s-bhatia1216/mt-rainier-railroad/physical_design/power_distribution_center.JPG

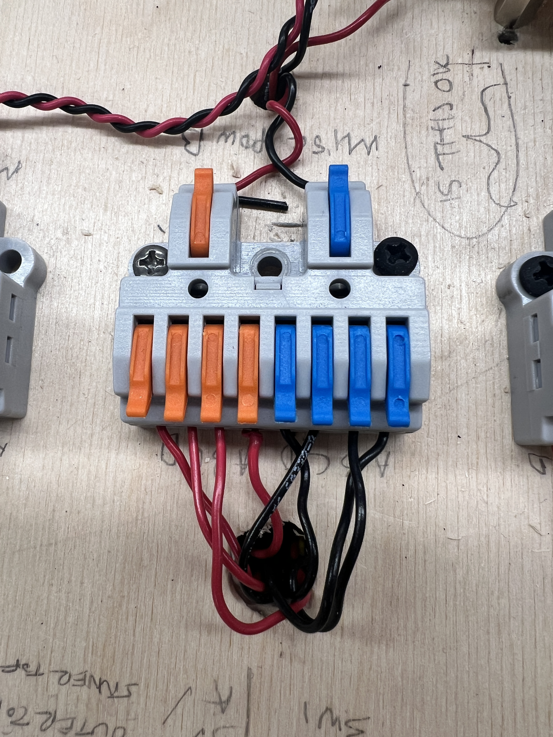
physical_design/power_distribution_center.JPG
