s-bhatia1216/mt-rainier-railroad/physical_design/tof_sensor.JPG

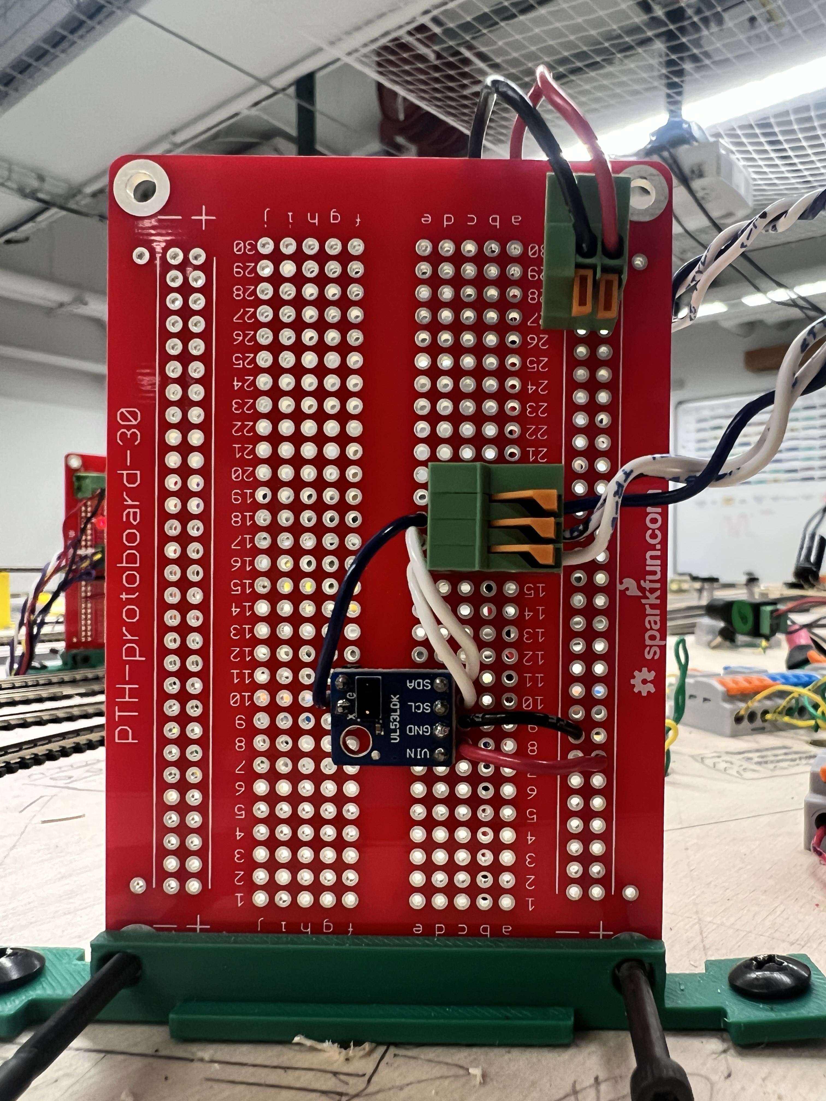
physical_design/tof_sensor.JPG
