s-bhatia1216/mt-rainier-railroad/Todos.docx

- Test super pro ram test
- Wiring
  - Wire power lines and ground lines from sensors into power centers
  - Wire power lines and ground lines from trees into power centers
  - Wire the voltage regulator power center (orange board)
  - Rewire trickle charge circuit – hriday is doing this
  - Add buffer onto the vector board
  - Wire the blue relay lines from the two relay plates, wire trickle charge white and blue lines from the 4 trickle charge centers
  - Install trickle charge 2’s screw properly
