s-bhatia1216/mt-rainier-railroad/DCC/Arduino/Todos_withtestdayplan.docx

Todos

- Mount vector board into wood
- URGENT
  - Wiring
    - Add wiring to the middle track and the right most track that’s connected to the 12V power of the rails (parallelize) using the power distribution block
    - Check all the kinks as underlined
- asf
  - Staple things underneath
  - Check all loose wires with pull tests
  - Sign names into the wood
  - fs
  - Do eraser thing on tracks
  - Make a document that indicates what to connect and start for testing

Test Day

- Power
  - Plug in 9V into VB
  - Plug in 9V into the MISC power distribution center
  - Plug in 24V into the rail power distribution center
  - Plug in Blue USB into the rail power Arduino
  - Plug in the 12V into the rail power Arduino
- Commands
  - Plug in the FTDI cable into the VB
  - Plug in the umblical cord

CONOPS

1. Starts at the rightmost point
2. FIRST OUTER LOOP (1x)
  a. SW1 is low to go straight into the SW2
  b. SW2 is low to go straight into the trk X
  c. SW4 is high to enter the trk5 outer loop
  d. SW3 is low to go straight into default loop
3. SECOND OUTER LOOP TO GO INTO INNER LOOP
  a. SW1 is low to go straight into the SW2
  b. SW2 is low to go straight into the trk X
  c. SW4 is high to enter the trk5 outer loop
  d. SW3 is low to go straight into default loop
4. THIRD INNER LOOP – assumes we just completed an outer loop at SW3
  a. SW1 is high to exit the default loop into the SW2
  b. SW2 is low to enter the trk4 inner loop
  c. SW3 is high to exit the trk4 inner loop
5. FOUTH INNER LOOP– assumes we just completed an outer loop at SW3
  a. SW1 is high to exit the default loop into the SW2
  b. SW2 is low to enter the trk4 inner loop
  c. SW3 is high to exit the trk4 inner loop
6. EXIT THE TRACK
  a. SW1 is high to exit the default loop into the SW2
  b. SW2 is low to go straight into the trk X
  c. SW4 is low to exit the track!
