s-bhatia1216/mt-rainier-railroad/electrical_schematics/relay_schematic.png

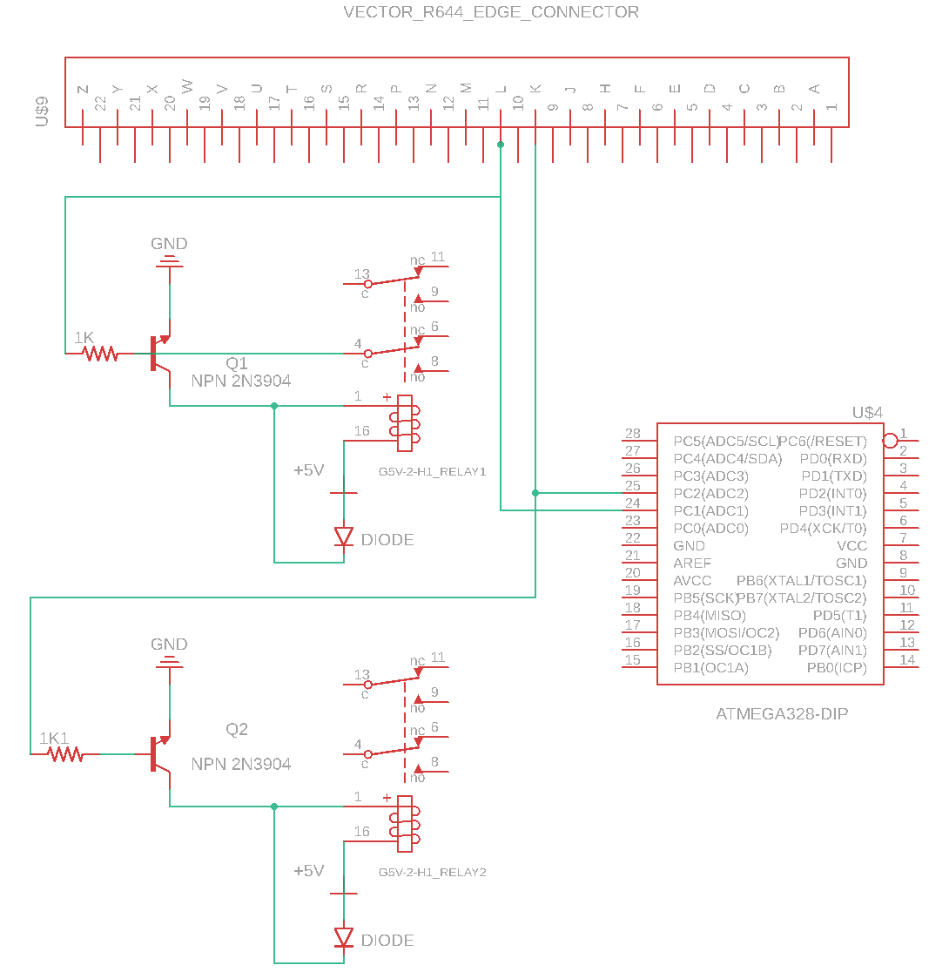
electrical_schematics/relay_schematic.png
