s-bhatia1216/mt-rainier-railroad/electrical_schematics/servo_schematic.png

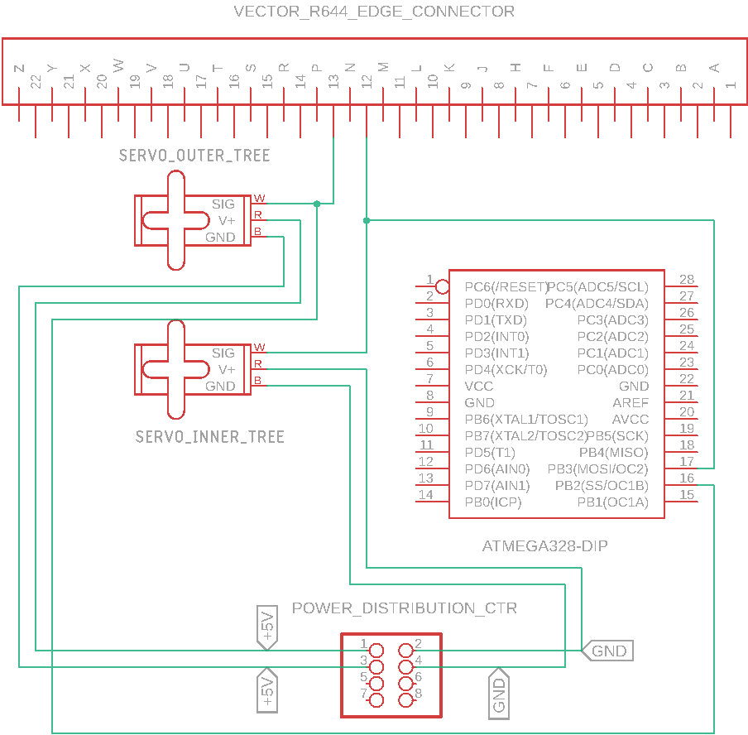
electrical_schematics/servo_schematic.png
