s-bhatia1216/mt-rainier-railroad/electrical_schematics/tof_schematic.png

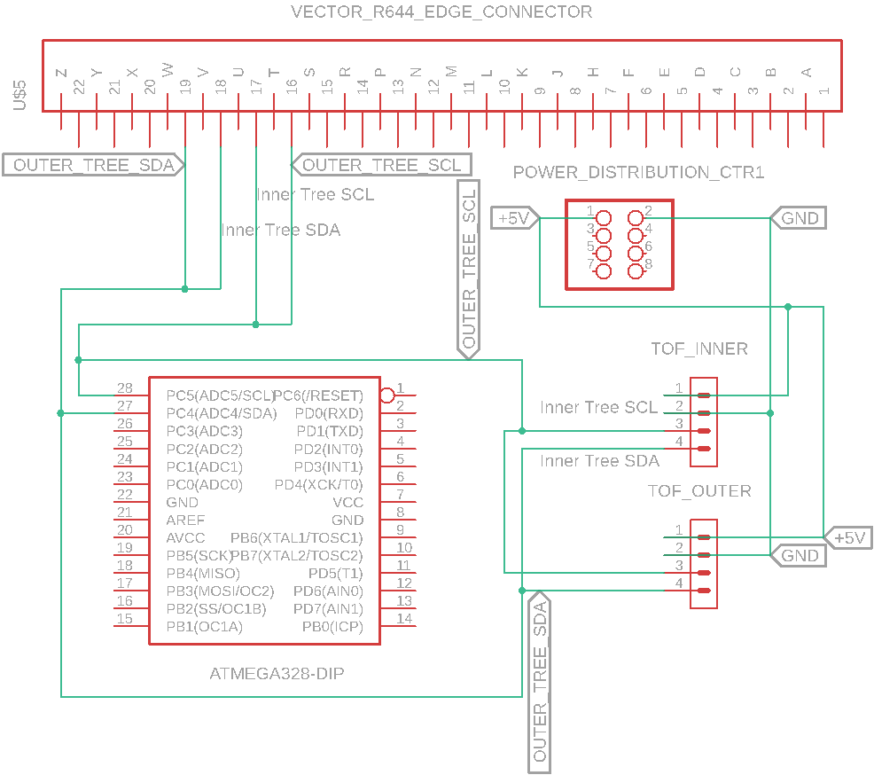
electrical_schematics/tof_schematic.png
