s-bhatia1216/mt-rainier-railroad/physical_design/power_relay.JPG

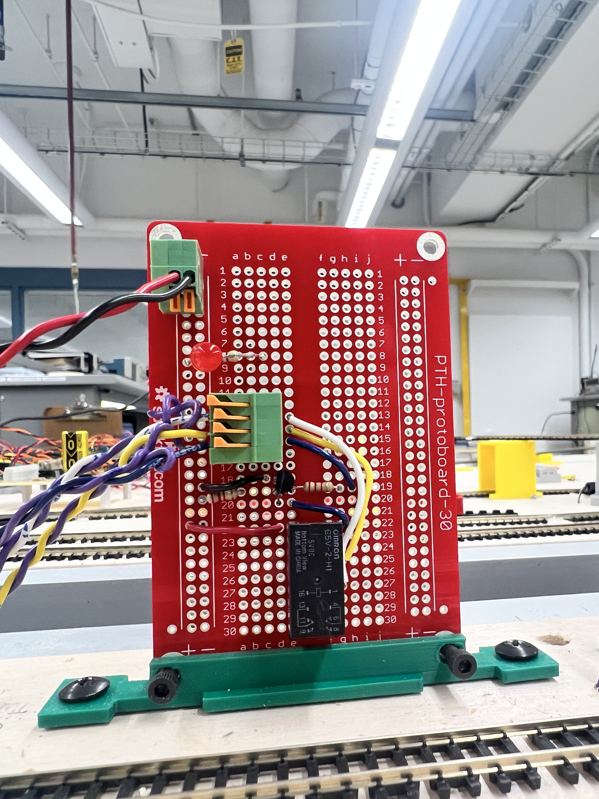
physical_design/power_relay.JPG
