s-bhatia1216/mt-rainier-railroad/physical_design/vector_board.JPG

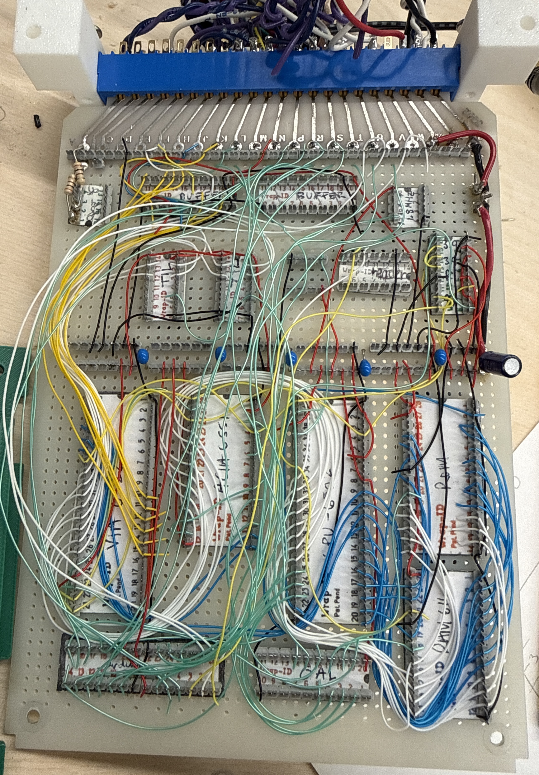
physical_design/vector_board.JPG
