s-bhatia1216/mt-rainier-railroad/electrical_schematics/General_Schematic_Files/Relay_Charge_Circuit.sch

## EAGLE design electrical_schematics/General_Schematic_Files/Relay_Charge_Circuit.sch (2026-05-09)

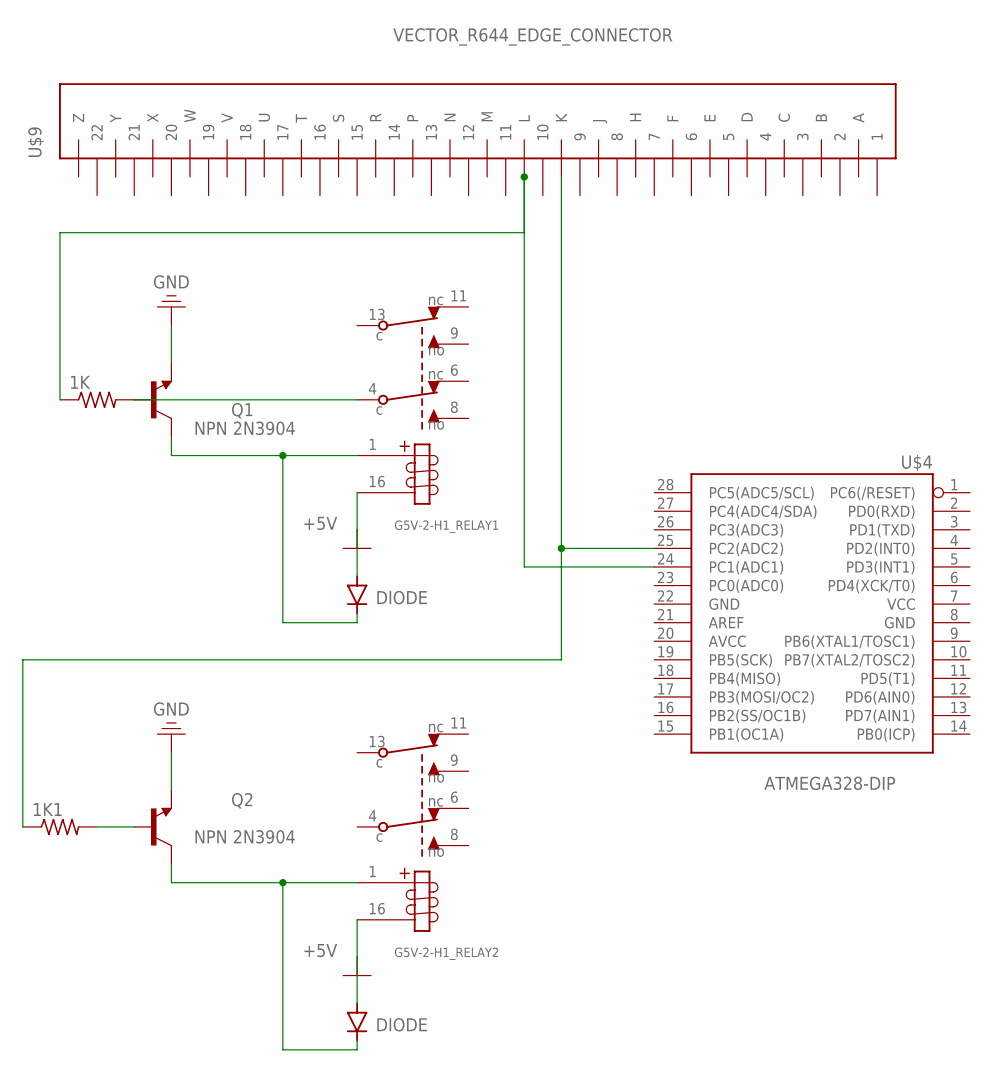
[picture p10: schematic Relay_Charge_Circuit.sch]

Parts:
1K, 1K1: R-US_0414/5V; 0414V
G5V-2-H1_RELAY1, G5V-2-H1_RELAY2: RELAY_DPDT; DIP16_RELAY
Q1, Q2: NPN 2N3904; TO92
U$3, U$6: DIODE; DIODE-DO-220AA(SMP)
U$4: ATMEGA328-DIP; DIP28
U$9: VECTOR_R644_EDGE_CONNECTOR; VECTOR44

Connections:
+5V: G5V-2-H1_RELAY1.16, G5V-2-H1_RELAY2.16, U$3.ANODE, U$6.ANODE
GND: Q1.3 (E), Q2.3 (E)
unnamed: G5V-2-H1_RELAY1.1, Q1.1 (C), U$3.CATHODE
unnamed: 1K.2, G5V-2-H1_RELAY1.P1, Q1.2 (B)
unnamed: 1K.1, U$4.24 (PC1(ADC1)), U$9.P$L (L)
unnamed: 1K1.2, Q2.2 (B)
unnamed: 1K1.1, U$4.25 (PC2(ADC2)), U$9.P$K (K)
unnamed: G5V-2-H1_RELAY2.1, Q2.1 (C), U$6.CATHODE
