s-bhatia1216/mt-rainier-railroad/electrical_schematics/General_Schematic_Files/Servo_Schematic.sch

## EAGLE design electrical_schematics/General_Schematic_Files/Servo_Schematic.sch (2026-05-09)

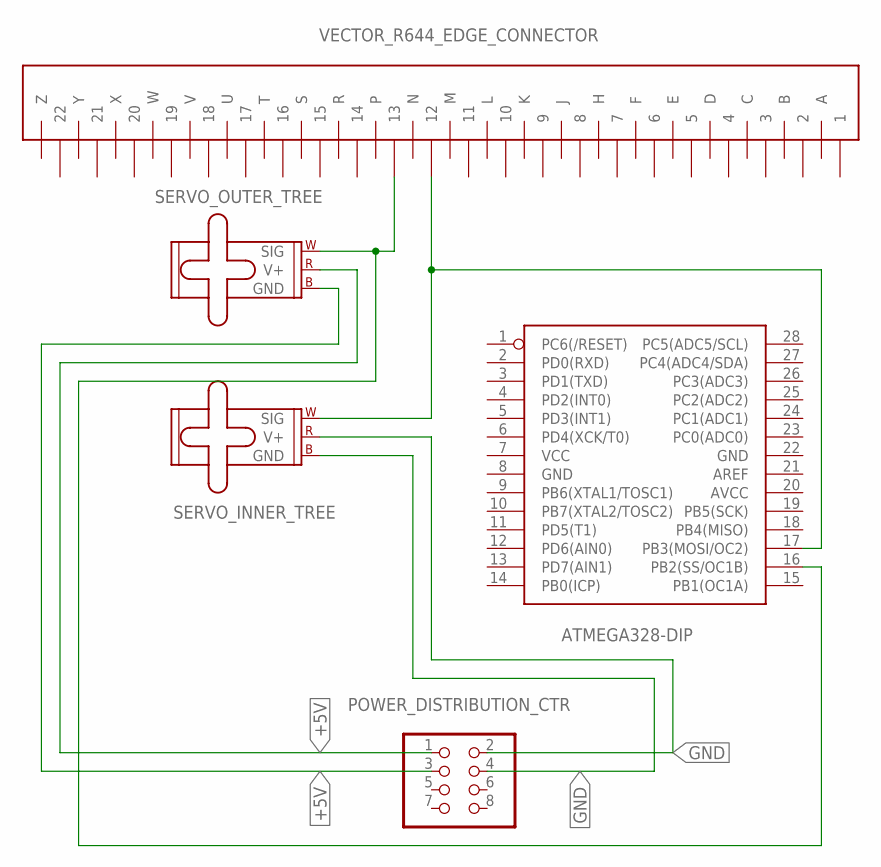
[picture p11: schematic Servo_Schematic.sch]

Parts:
POWER_DISTRIBUTION_CTR: PINHD-2X4; 2X04
SERVO_INNER_TREE: SERVO; 1X03
SERVO_OUTER_TREE: SERVO; 1X03
U$7: ATMEGA328-DIP; DIP28
U$8: VECTOR_R644_EDGE_CONNECTOR; VECTOR44

Connections:
+5V: POWER_DISTRIBUTION_CTR.1, POWER_DISTRIBUTION_CTR.3, SERVO_OUTER_TREE.2 (V+), SERVO_OUTER_TREE.3 (GND)
GND: POWER_DISTRIBUTION_CTR.2, POWER_DISTRIBUTION_CTR.4, SERVO_INNER_TREE.2 (V+), SERVO_INNER_TREE.3 (GND)
unnamed: SERVO_INNER_TREE.1 (SIG), U$7.17 (PB3(MOSI/OC2)), U$8.P$12 (12)
unnamed: SERVO_OUTER_TREE.1 (SIG), U$7.16 (PB2(SS/OC1B)), U$8.P$13 (13)
