s-bhatia1216/mt-rainier-railroad/electrical_schematics/General_Schematic_Files/ToF_Circuit.sch

## EAGLE design electrical_schematics/General_Schematic_Files/ToF_Circuit.sch (2026-05-09)

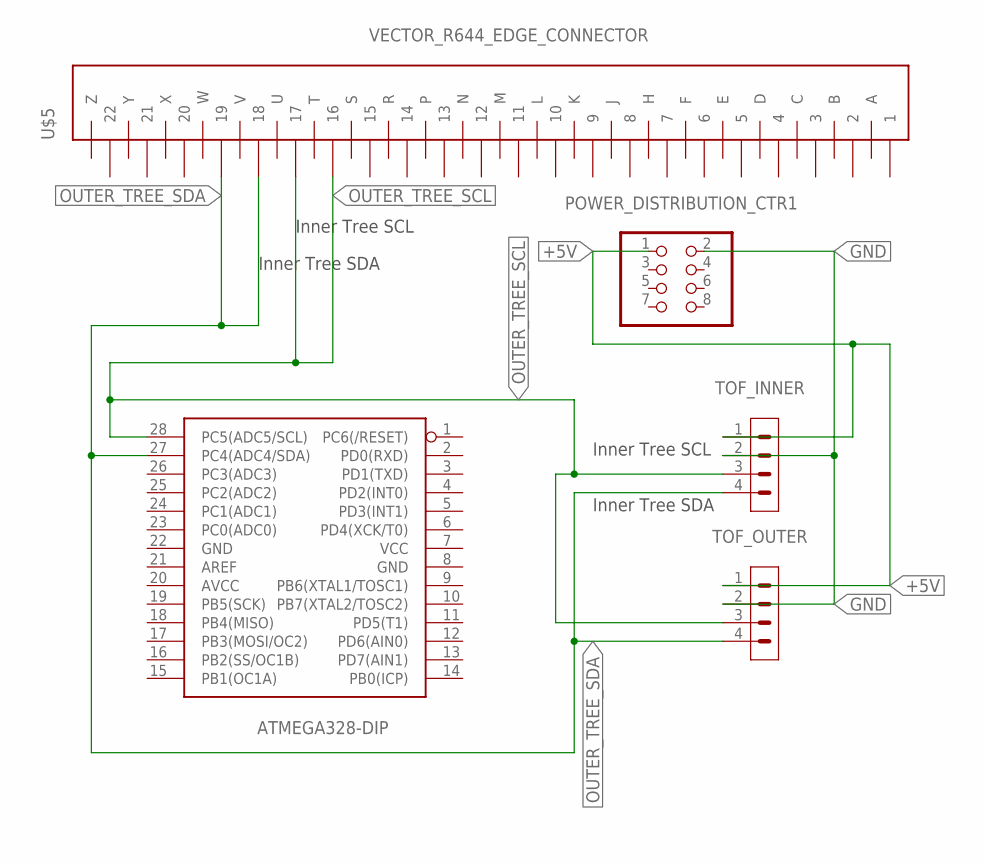
[picture p12: schematic ToF_Circuit.sch]

Parts:
POWER_DISTRIBUTION_CTR1: PINHD-2X4; 2X04
TOF_INNER: PINHD-1X4; 1X04
TOF_OUTER: PINHD-1X4; 1X04
U$5: VECTOR_R644_EDGE_CONNECTOR; VECTOR44
U$10: ATMEGA328-DIP; DIP28

Connections:
+5V: POWER_DISTRIBUTION_CTR1.1, TOF_INNER.1, TOF_OUTER.1
GND: POWER_DISTRIBUTION_CTR1.2, TOF_INNER.2, TOF_OUTER.2
OUTER_TREE_SCL: TOF_INNER.3, TOF_OUTER.3, U$5.P$16 (16), U$5.P$17 (17), U$10.28 (PC5(ADC5/SCL))
OUTER_TREE_SDA: TOF_INNER.4, TOF_OUTER.4, U$5.P$18 (18), U$5.P$19 (19), U$10.27 (PC4(ADC4/SDA))

Notes on the sheet:
Inner Tree SCL
Inner Tree SDA
