s-bhatia1216/mt-rainier-railroad/electrical_schematics/General_Schematic_Files/Vector_Board.sch

## EAGLE design electrical_schematics/General_Schematic_Files/Vector_Board.sch (2026-05-09)

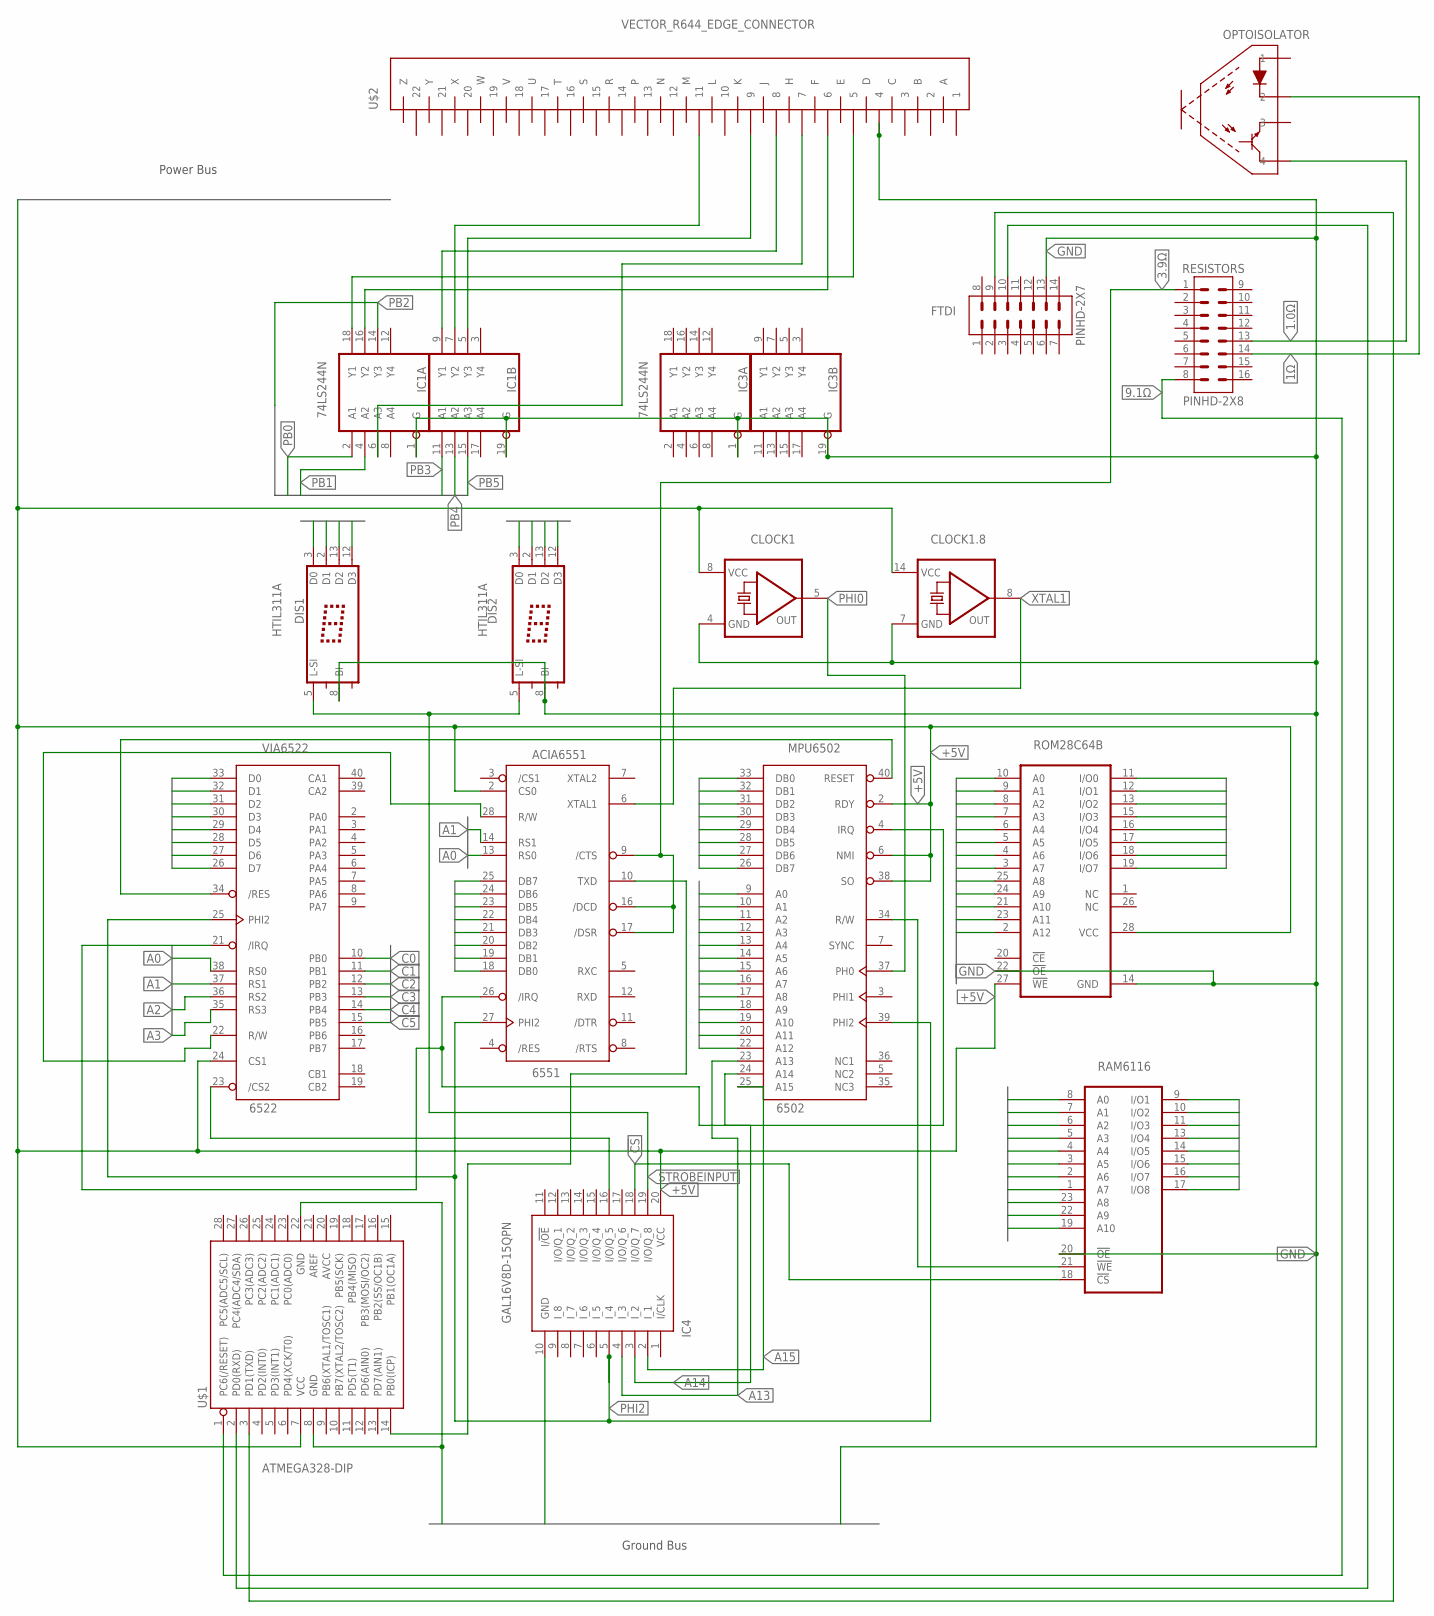
[picture p13: schematic Vector_Board.sch]

Parts:
ACIA6551: 6551; DIP28
CLOCK1: QG5460; DIL08S
CLOCK1.8: QG5860; DIL14S
DIS1, DIS2: HTIL311A
FTDI: PINHD-2X7; 2X07
IC1, IC3: 74LS244N; DIL20
IC4: GAL16V8D-15QPN; DIP794W56P254L2591H533Q20N
MPU6502: 6502; DIP40
OPTOISOLATOR: OPB7XX_OPTICAL
RAM6116: 6116P; DIL24-6
RESISTORS: PINHD-2X8; 2X08
ROM28C64B: 28C64C; DIL28-6
U$1: ATMEGA328-DIP; DIP28
U$2: VECTOR_R644_EDGE_CONNECTOR; VECTOR44
VIA6522: 6522; DIP40

Connections:
1.0Ω: OPTOISOLATOR.P$4 (4), RESISTORS.13
1Ω: OPTOISOLATOR.P$2 (2), RESISTORS.14
3.9Ω: ACIA6551.9 (/CTS), ACIA6551.16 (/DCD), ACIA6551.17 (/DSR), RESISTORS.1
9.1Ω: RESISTORS.8, U$1.1 (PC6(/RESET))
!CS: IC4.18 (I/O/Q_7), RAM6116.18 (!CS)
+5V: ACIA6551.2 (CS0), CLOCK1.8 (VCC), CLOCK1.8.14 (VCC), IC4.20 (VCC), MPU6502.2 (RDY), MPU6502.6 (NMI), MPU6502.38 (SO), ROM28C64B.27 (!WE), ROM28C64B.28 (VCC), U$1.7 (VCC), VIA6522.24 (CS1)
A0: ACIA6551.13 (RS0), MPU6502.9 (A0), RAM6116.8 (A0), ROM28C64B.10 (A0), VIA6522.38 (RS0)
A1: ACIA6551.14 (RS1), MPU6502.10 (A1), RAM6116.7 (A1), ROM28C64B.9 (A1), VIA6522.37 (RS1)
A2: MPU6502.11 (A2), RAM6116.6 (A2), ROM28C64B.8 (A2), VIA6522.36 (RS2)
A3: MPU6502.12 (A3), RAM6116.5 (A3), ROM28C64B.7 (A3), VIA6522.35 (RS3)
A4: MPU6502.13 (A4), RAM6116.4 (A4), ROM28C64B.6 (A4)
A5: MPU6502.14 (A5), RAM6116.3 (A5), ROM28C64B.5 (A5)
A6: MPU6502.15 (A6), RAM6116.2 (A6), ROM28C64B.4 (A6)
A7: MPU6502.16 (A7), RAM6116.1 (A7), ROM28C64B.3 (A7)
A8: MPU6502.17 (A8), RAM6116.23 (A8), ROM28C64B.25 (A8)
A9: MPU6502.18 (A9), RAM6116.22 (A9), ROM28C64B.24 (A9)
A10: MPU6502.19 (A10), RAM6116.19 (A10), ROM28C64B.21 (A10)
A11: MPU6502.20 (A11), ROM28C64B.23 (A11)
A12: MPU6502.22 (A12), ROM28C64B.2 (A12)
A13: IC4.4 (I_3), MPU6502.23 (A13)
A14: IC4.3 (I_2), MPU6502.24 (A14)
A15: IC4.2 (I_1), MPU6502.25 (A15)
C0: VIA6522.10 (PB0)
C1: VIA6522.11 (PB1)
C2: VIA6522.12 (PB2)
C3: VIA6522.13 (PB3)
C4: VIA6522.14 (PB4)
C5: VIA6522.15 (PB5)
D0: ACIA6551.18 (DB0), DIS1.3 (D0), MPU6502.33 (DB0), RAM6116.9 (I/O1), ROM28C64B.11 (I/O0), VIA6522.33 (D0)
D1: ACIA6551.19 (DB1), DIS1.2 (D1), MPU6502.32 (DB1), RAM6116.10 (I/O2), ROM28C64B.12 (I/O1), VIA6522.32 (D1)
D2: ACIA6551.20 (DB2), DIS1.13 (D2), MPU6502.31 (DB2), RAM6116.11 (I/O3), ROM28C64B.13 (I/O2), VIA6522.31 (D2)
D3: ACIA6551.21 (DB3), DIS1.12 (D3), DIS2.12 (D3), MPU6502.30 (DB3), RAM6116.13 (I/O4), ROM28C64B.15 (I/O3), VIA6522.30 (D3)
D4: ACIA6551.22 (DB4), DIS2.3 (D0), MPU6502.29 (DB4), RAM6116.14 (I/O5), ROM28C64B.16 (I/O4), VIA6522.29 (D4)
D5: ACIA6551.23 (DB5), DIS2.2 (D1), MPU6502.28 (DB5), RAM6116.15 (I/O6), ROM28C64B.17 (I/O5), VIA6522.28 (D5)
D6: ACIA6551.24 (DB6), DIS2.13 (D2), MPU6502.27 (DB6), RAM6116.16 (I/O7), ROM28C64B.18 (I/O6), VIA6522.27 (D6)
D7: ACIA6551.25 (DB7), MPU6502.26 (DB7), RAM6116.17 (I/O8), ROM28C64B.19 (I/O7), VIA6522.26 (D7)
G0: IC4.10 (GND)
G1: U$1.8 (GND), U$1.22 (GND)
GND: CLOCK1.4 (GND), CLOCK1.8.7 (GND), DIS1.8 (BI), DIS2.8 (BI), FTDI.13, IC1.1 (G), IC1.19 (G), IC3.1 (G), IC3.19 (G), RAM6116.20 (!OE), ROM28C64B.14 (GND), ROM28C64B.22 (!OE), U$2.P$4 (4)
unnamed: IC1.18 (Y1), U$2.P$5 (5)
unnamed: IC1.16 (Y2), U$2.P$6 (6)
unnamed: IC1.6 (A3), U$2.P$7 (7)
unnamed: IC1.9 (Y1), U$2.P$8 (8)
unnamed: IC1.5 (Y3), U$2.P$9 (9)
unnamed: IC4.16 (I/O/Q_5), VIA6522.23 (/CS2)
unnamed: IC1.7 (Y2), U$2.P$11 (11)
unnamed: FTDI.9, U$1.3 (PD1(TXD))
unnamed: FTDI.10, U$1.2 (PD0(RXD))
unnamed: ACIA6551.26 (/IRQ), MPU6502.4 (IRQ), VIA6522.21 (/IRQ)
unnamed: MPU6502.34 (R/W), RAM6116.21 (!WE)
unnamed: MPU6502.40 (RESET), VIA6522.34 (/RES)
unnamed: ACIA6551.28 (R/W), VIA6522.22 (R/W)
unnamed: ACIA6551.10 (TXD), U$1.14 (PB0(ICP))
PB0: IC1.2 (A1)
PB1: IC1.4 (A2)
PB2: IC1.14 (Y3)
PB3: IC1.11 (A1)
PB4: IC1.13 (A2)
PB5: IC1.15 (A3)
PHI0: CLOCK1.5 (OUT), MPU6502.37 (PH0)
PHI2: ACIA6551.27 (PHI2), IC4.5 (I_4), MPU6502.39 (PHI2), VIA6522.25 (PHI2)
STROBEINPUT: DIS1.5 (L-SI), DIS2.5 (L-SI), IC4.19 (I/O/Q_8)
XTAL1: ACIA6551.6 (XTAL1), CLOCK1.8.8 (OUT)

Notes on the sheet:
Power Bus
Ground Bus
