s-bhatia1216/mt-rainier-railroad/DCC/bridge_direct.py

import serial
import time

arduino = serial.Serial('COM3', 115200, timeout=1)  # FTDI cable from Vector Board Arduino
dcc = serial.Serial('COM4', 115200, timeout=1)      # Command Station (Arduino Uno + motor shield)

time.sleep(1)

print("Transparent bridge running...")

while True:
    if arduino.in_waiting:
        data = arduino.readline()   # raw bytes
        print("Forwarding:", data)

        dcc.write(data)             # send exactly as-is
        dcc.flush()
