s-bhatia1216/mt-rainier-railroad/(commit log)

2026-05-07 init track power control
2026-05-07 track power works yayyy
2026-05-07 track switch logic works
2026-05-07 perchance the switches work
2026-05-07 switches-power perhaps
2026-05-07 working switches individual test
2026-05-08 switches w/ conops
2026-05-08 init switch setup
2026-05-08 timing based switches
2026-05-08 sequential switching
2026-05-08 switches test
2026-05-08 DUAL WORKING AT THE SAME TIME, FRAMEWORK FOR SONAL
2026-05-08 delay between each switch actuation
2026-05-08 switch 2 to HIGH
2026-05-08 print statementsss
2026-05-08 removed print statements to preserve arduino sram
2026-05-08 fixed pin naming
2026-05-08 Print staement
2026-05-08 WORKING CODE THE POWER PLUS SWITCHES IS EXACTLY WHAT WE WANT
2026-05-09 physical design photos and electrical schematics
    [Relay_Charge_Circuit.sch, Servo_Schematic.sch, ToF_Circuit.sch, Vector_Board.sch]
2026-05-09 when ntrain != 0 fires (train enters your block), switchingActive = true
