s-bhatia1216/mt-rainier-railroad/physical_design/track_power_distribution_center.JPG

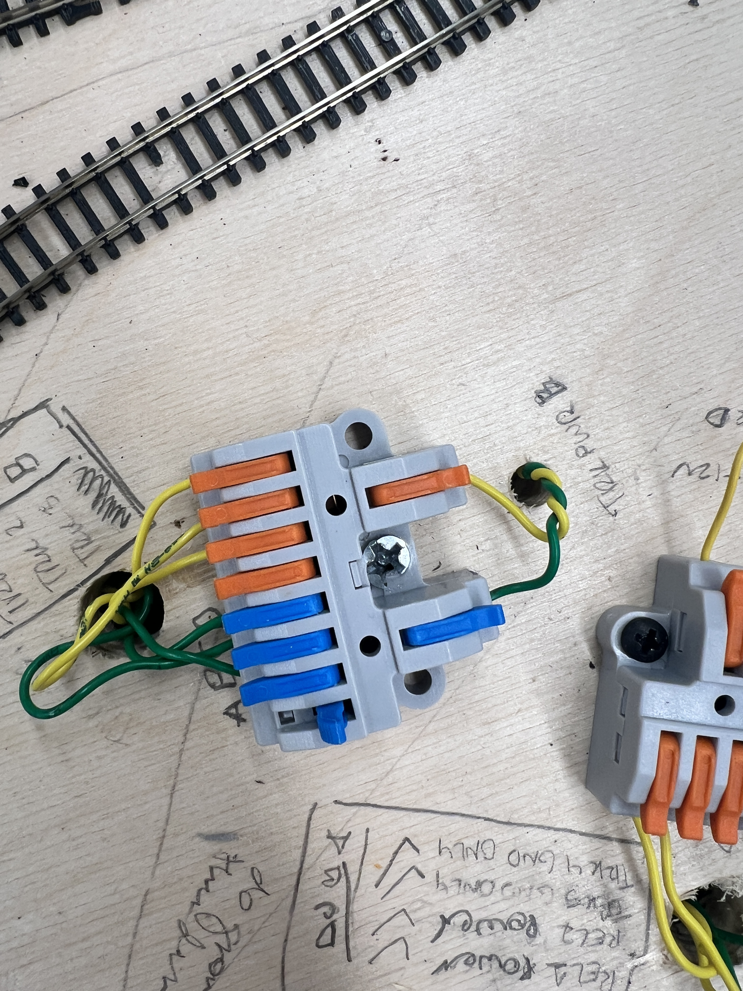
physical_design/track_power_distribution_center.JPG
