s-bhatia1216/mt-rainier-railroad/physical_design/trickle_charge_circuit.JPG

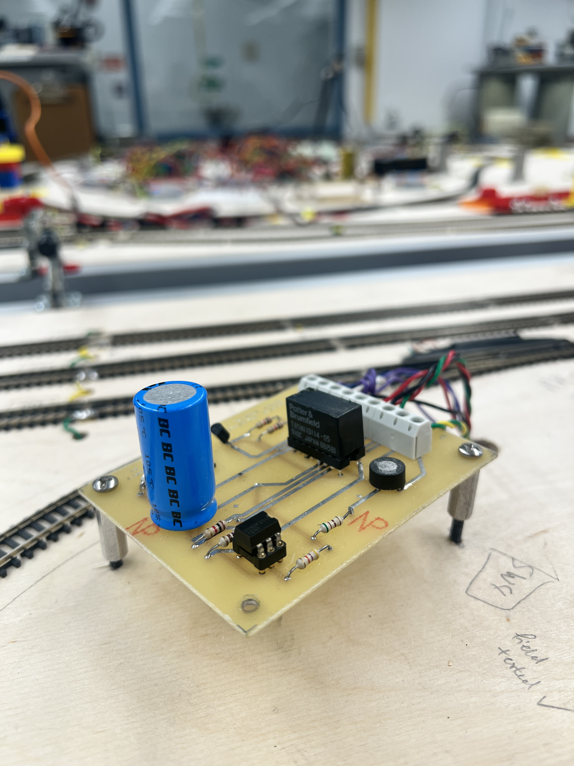
physical_design/trickle_charge_circuit.JPG
